OLIMEX/POEv3/README.md

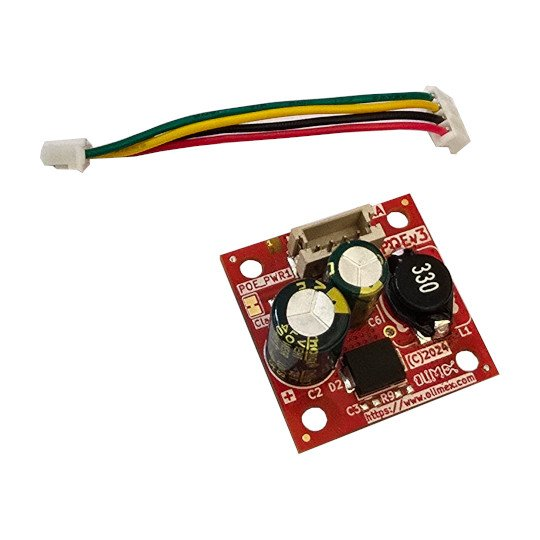
[picture p1: DOCUMENTS/POEv3-1.jpg]
POEv3-1

# POEv3
Power Over Ethernet 802.03af compatible non isolated power supply module

## License
* Hardware is released under Apache 2.0 License
* Software is released under GPL3 License
* Documentation is released under CC BY-SA 3.0
