OLIMEX/POEv3/DOCUMENTS/POEv3.odt

POEv3

User Manual

Rev.1.0 March 2025 olimex.com

# Introduction to POEv3

POEv3 (https://www.olimex.com/Products/IoT/ESP32-P4/POEv3/open-source-hardware) is small 25x25mm Power Over Ethernet negotiator and voltage regulator. It is designed to work with ESP32-P4-Devkit (https://www.olimex.com/Products/IoT/ESP32-P4/ESP32-P4-DevKit/open-source-hardware) but it will work with any other board which have POE capable magnetic transformer.

The maximal current of POEv3 (https://www.olimex.com/Products/IoT/ESP32-P4/POEv3/open-source-hardware) is about 1A, although it will be able to provide more we do not recommend to be used with higher power without active cooling.

Note:

POEv3 (https://www.olimex.com/Products/IoT/ESP32-P4/POEv3/open-source-hardware) is not galvanically isolated. It provides 5V 1A to the target board but it’s connected to the Ethernet cable, so care should be taken when operating with the product powered by POEv3 (https://www.olimex.com/Products/IoT/ESP32-P4/POEv3/open-source-hardware).

# Order codes for POEv3:

POEv3 (https://www.olimex.com/Products/IoT/ESP32-P4/POEv3/open-source-hardware) industrial grade Power over Ethernet negotiator and voltage regulator

# HARDWARE

## POEv3 schematic

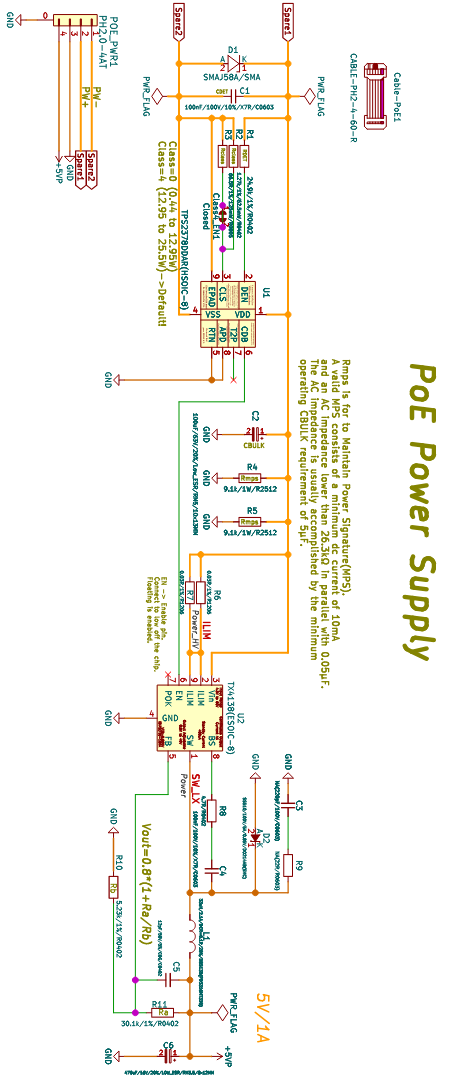
[picture p2: figure]

# POEv3 connector:

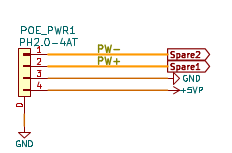
[picture p3: figure]

# Revision History

Revision 1.0 March 2025
