OLIMEX/POEv3/Hardware/POEv3 hardware revision A/POEv3_Rev_A.pdf

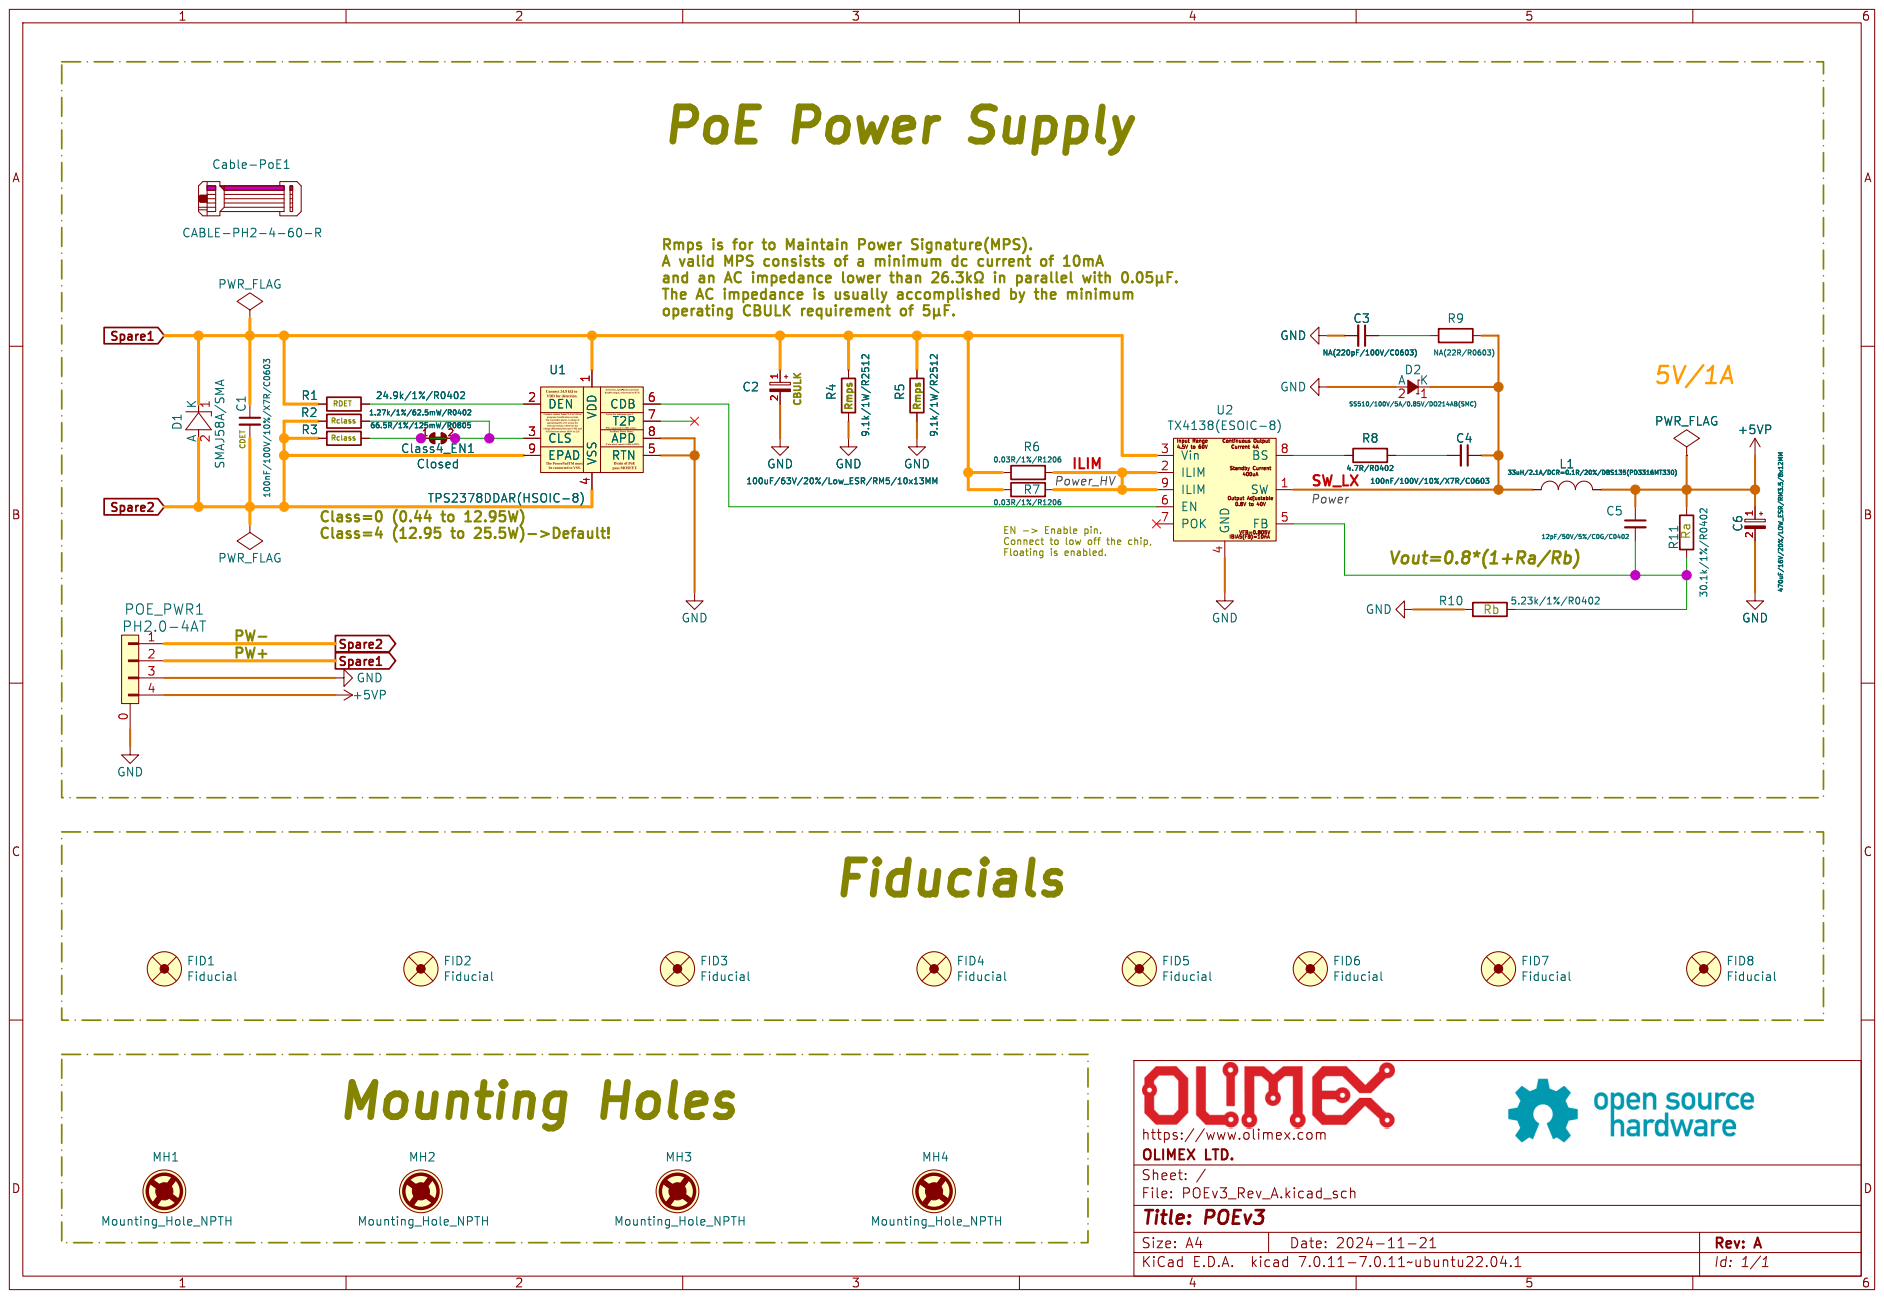
[picture p4: page 1]

Rmps is for to Maintain Power Signature(MPS). A valid MPS consists of a minimum dc current of 10mA

4 RTN 5 CDB 6 T2P 7 APD 8 EPAD 9 U1 TPS2378DDAR(HSOIC-8) R10 5.23k/1%/R0402 GND GND

4 RTN 5 CDB 6 T2P 7 APD 8 EPAD 9 C2

AuxiliaryPowerDetect Activelowindicatestype2 Activelow,open-drainconverterdisable output,referencedtoRTN. Connect24.9þÿk©toVDD for detection. ConnectresistorfromCLS toVSStoprogram classificationcurrent.

If notused,connectAPD toRTN. PSEconnectedor APD active. ThePowerPadTMmustbe connectedtoVSS.VDD

The controllerplacesa voltageof approximately 2.5Vacrosstheexternal resistorwheneverthevoltage differentialbetweenVDD andVSS liesfromabout10.9Vto22V. Drain ofPoEpass MOSFET.

4 FB 5 EN 6 POK 7 BS 8
