OLIMEX/POEv3/Hardware/POEv3 hardware revision A/POEv3_Rev_A.kicad_pcb

## KiCad design Hardware/POEv3 hardware revision A/POEv3_Rev_A.kicad_pcb (2025-03-14)

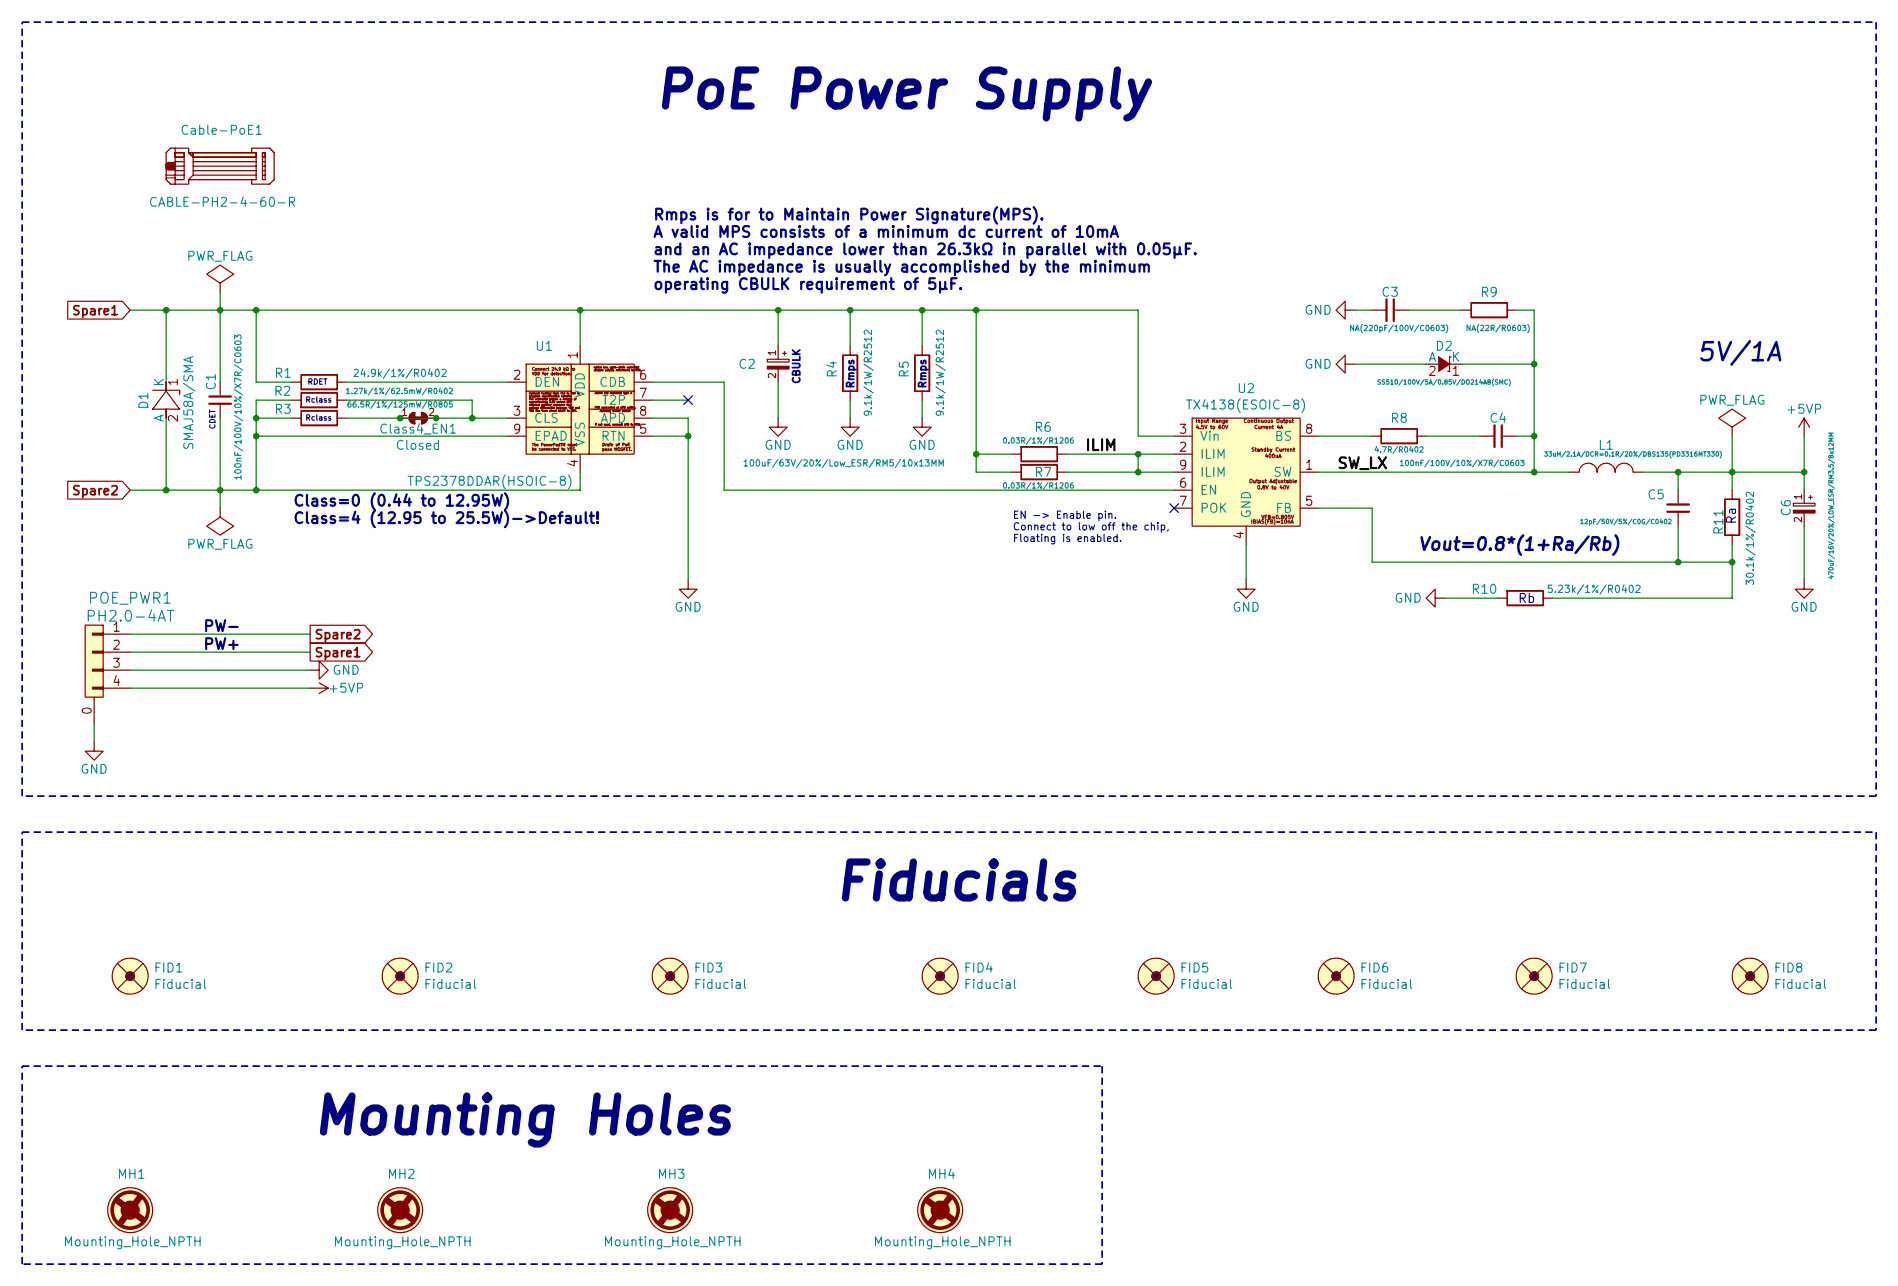
[picture p5: schematic POEv3_Rev_A.kicad_sch, POEv3]

Parts:
C1, C4: 100nF/100V/10%/X7R/C0603; C_0603_5MIL_DWS
C2: 100uF/63V/20%/Low_ESR/RM5/10x13MM; CPOL-RM5mm_10.0x16.0mm_PTH
C3: NA(220pF/100V/C0603); C_0603_5MIL_DWS
C5: 12pF/50V/5%/C0G/C0402; C_0402_5MIL_DWS
C6: 470uF/16V/20%/LOW_ESR/RM3.5/8x12MM; CPOL-RM3.5mm_8.0x11.5mm_PTH
Cable-PoE1: CABLE-PH2-4-60-R; Cable-IDC
Class4_EN1: Closed; SJ_Closed
D1: SMAJ58A/SMA; SMA-KA
D2: SS510/100V/5A/0.85V/DO214AB(SMC); DO214AB(SMC)_1(K)-2(A)
FID1, FID2, FID5, FID6: Fiducial; Fiducial1x3
FID3, FID4, FID7, FID8: Fiducial; Fiducial1x3_Paste
L1: 33uH/2.1A/DCR=0.1R/20%/DBS135(PD3316MT330); HSMRH129_12.0x12.5x9.5(max)
MH1, MH2, MH3, MH4: Mounting_Hole_NPTH; Mounting_Hole_Drill-3.3mm_Clerance-7mm
POE_PWR1: PH2.0-4AT; PH2.0-4PLB
R1: 24.9k/1%/R0402; R_0402_5MIL_DWS
R2: 1.27k/1%/62.5mW/R0402; R_0402_5MIL_DWS
R3: 66.5R/1%/125mW/R0805; R_0805_5MIL_DWS
R4, R5: 9.1k/1W/R2512; R_2512_MM_DWS
R6, R7: 0.03R/1%/R1206; R_1206_5MIL_DWS
R8: 4.7R/R0402; R_0402_5MIL_DWS
R9: NA(22R/R0603); R_0603_5MIL_DWS
R10: 5.23k/1%/R0402; R_0402_5MIL_DWS
R11: 30.1k/1%/R0402; R_0402_5MIL_DWS
U1: TPS2378DDAR(HSOIC-8); ESOIC-8
U2: TX4138(ESOIC-8); ESOIC-8

Connections:
+5VP: C5.1, C6.1 (+), L1.2, POE_PWR1.4 (P2), R11.1
/ILIM: R6.1, R7.1, U2.2 (ILIM), U2.9 (ILIM)
/SW_LX: C4.1, D2.1 (K), L1.1, R9.2, U2.1 (SW)
GND: C2.2 (-), C3.2, C6.2 (-), D2.2 (A), POE_PWR1.0, POE_PWR1.3 (P2), R4.2, R5.2, R10.2, U1.5 (RTN), U1.8 (APD), U2.4 (GND)
unnamed: C3.1, R9.1
unnamed: C4.2, R8.2
unnamed: U1.6 (CDB), U2.6 (EN)
unnamed: Class4_EN1.1, Class4_EN1.2, R2.1, R3.2, U1.3 (CLS)
unnamed: R1.2, U1.2 (DEN)
unnamed: R8.1, U2.8 (BS)
unnamed: C5.2, R10.1, R11.2, U2.5 (FB)
Spare1: C1.1, C2.1 (+), D1.1 (K), POE_PWR1.2, R1.1, R4.1, R5.1, R6.2, R7.2, U1.1 (VDD), U2.3 (Vin)
Spare2: C1.2, D1.2 (A), POE_PWR1.1, R2.2, R3.1, U1.4 (VSS), U1.9 (EPAD)

Notes on the sheet:
PW+
Vout=0.8*(1+Ra/Rb)
Rmps
RDET
Class=0 (0.44 to 12.95W) Class=4 (12.95 to 25.5W)->Default!
Rclass
5V/1A
CDET
Rmps is for to Maintain Power Signature(MPS). A valid MPS consists of a minimum dc current of 10mA and an AC impedance lower than 26.3kΩ in parallel with 0.05μF. The AC impedance is usually accomplished by the minimum operating CBULK requirement of 5μF.
CBULK
PW-
EN -> Enable pin. Connect to low off the chip, Floating is enabled.
Fiducials
Mounting Holes
PoE Power Supply

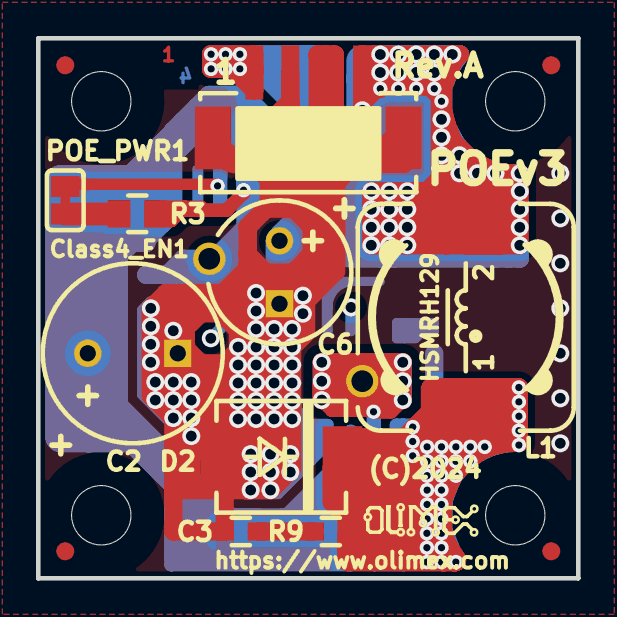
[picture p6: board POEv3_Rev_A.kicad_pcb from above]

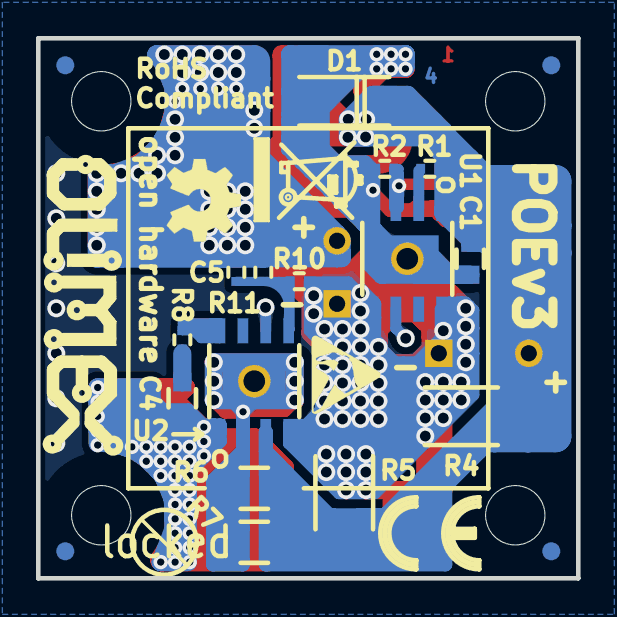
[picture p7: board POEv3_Rev_A.kicad_pcb from below]

Board: 4 copper layers, 30.0 x 30.0 mm, 44 parts (25 on the bottom side), 13 nets.

Other parts of the board:
Logo_OLIMEX_SMALL_TB: Logo_OLIMEX_SMALL_TB
Logo_OLIMEX_TB: Logo_OLIMEX_TB
Sign_Antistatic_150: Sign_Antistatic_150
Sign_CE: CE_Sign
Sign_OSHW_7.3x6.0mm: Sign_OSHW_7.3x6.0mm; Sign_OSHW_7.3x6.0mmn
Sign_PB-Free: Sign_PB-Free
Sign_RecycleBin_1: Sign_RecycleBin_1
