OLIMEX/POEv3/Hardware/Hardware-revision-changes.txt

POEv3 was designed with KiCAD - free and open source CAD software

Hardware revision changes:

Hardware revision A
- initial release
