OLIMEX/POEv3/(threads)

Thread 1 (2025-04-18):

Please consider pulsed MPS

marekm72, 2025-04-18:
Same applies to other boards with PoE and the MPS resistor that wastes quite a lot of power.
Two possible solutions come to mind (or a combination of both):
 - add a small FET switching the resistors on/off, minimum on time 75 ms, maximum off time 250 ms
 - add a small shunt resistor in the negative wire and a comparator to disable the MPS if the measured current (excluding the MPS load resistor itself) is above 10 mA
The pulses could be generated with a 555 but that requires extra components and long time constants, so probably a small MCU would be a better option today, and in non-isolated PoE modules it can be powered from the +5V output.  ATtiny10 in SOT23-6 looks like one suitable choice with small size on the PCB, measure the small shunt voltage with the ADC and compare against the threshold to decide if the heater needs to be on.  Bypass the shunt with another FET (also controlled with the MCU) while the current is not being measured, to reduce loss at much higher currents.
Maybe it will not save the planet after all, but the 0.5 watts of electricity saved is about 4 kWh/year which should roughly offset the cost of the added components (much more so if the product lasts much longer than a year - I hope so), and reliability (one less heat source) is another thing to consider.

Thread 2 (2025-09-04):

every file under DOCUMENTS is broken

arrise, 2025-09-04:
All three files in DOCUMENTS are currently broken and will not open or download.
Additionally it appears "Hardware/POEv3 hardware revision A/POEv3_Rev_A.pdf" is also broken.

TsvetanUsunov, 2025-09-05:
I just check them and everything is OK

Closed 2025-09-05.
