OLIMEX/POEv3/(notices)

Notices in the files:
Hardware/POEv3 hardware revision A/POEv3_Rev_A.kicad_pcb:
(C)2024
